Yashodhandesh/B6_Prototyping_2022/Prtotyping_1_tinkercad.jpg

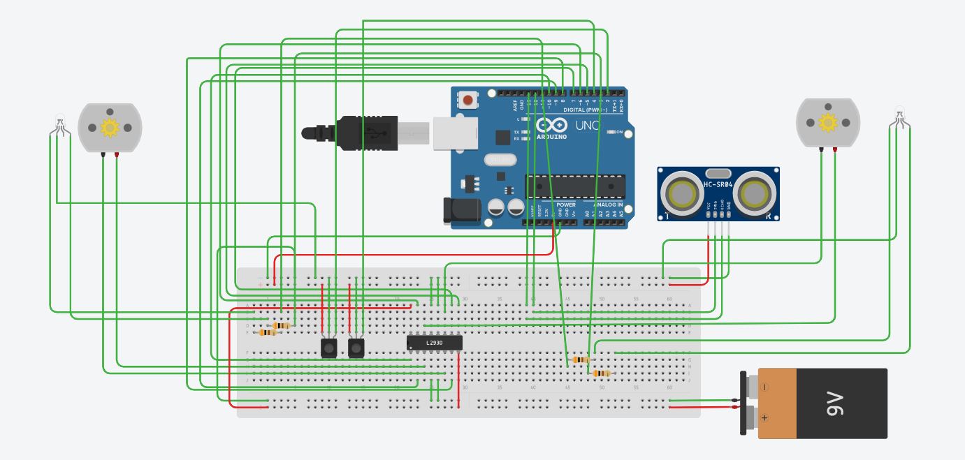
Prtotyping_1_tinkercad.jpg
