Yashodhandesh/B6_Prototyping_2022/design_style/DESIGN DISCUSSION(RETRO).pdf

DESIGN DISCUSSION(RETRO)

The aim is to recreate a vintage car design we know of but keep it simple.
The design had series of rounded edges as a normal vintage car look It also has the wheel bumper that was frequently used in old school cars. Our front part of the car consists of a well-designed classic bonnet with strips of line like was very prominent in classic cars.

We covered the battery part of the car to make the design more aesthetically pleasing.
We also added 4 wheels instead of 2 and a front wheel to give the car more movement capabilities and more balance.
The breadboard remained in the same position as it gives the car a classic Mercedes Benz look standing in as the flyer of the car. Our electronic components more or less remained a part of the design but their functional requirement was not met as we intended a more stylistic result.9
