Yashodhandesh/B6_Prototyping_2022/PROTOTYPING DOCUMENTATION/Affidavit/2022-06-19 10_19_44-affidevate.docx - yashodhan.pdf

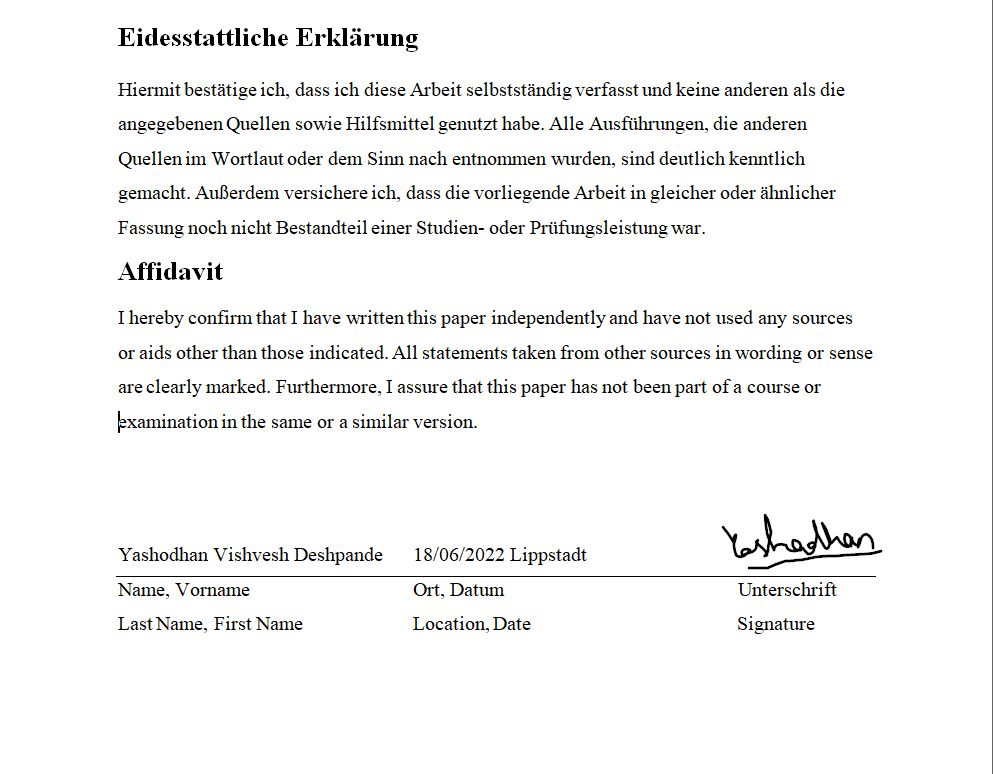
[picture p46: page 1]
