Yashodhandesh/B6_Prototyping_2022/final_system_engineering_model/Activity final.jpeg

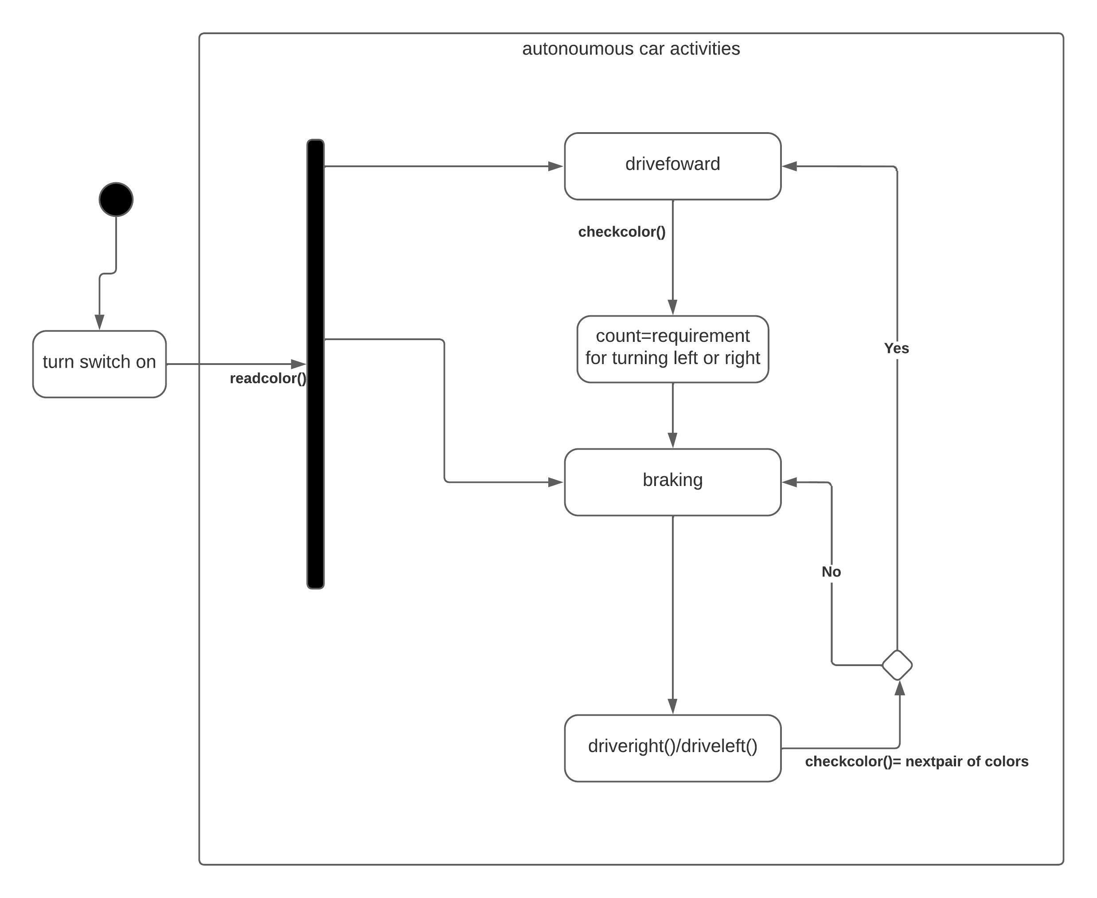
final_system_engineering_model/Activity final.jpeg
