Yashodhandesh/B6_Prototyping_2022/final_system_engineering_model/smart car bbd.jpg

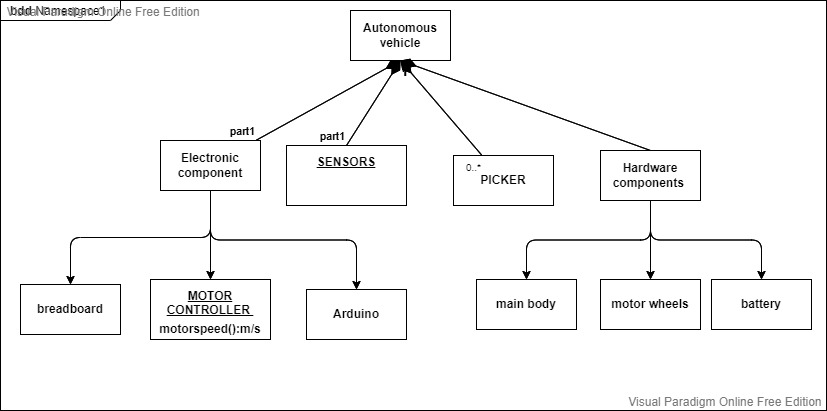
final_system_engineering_model/smart car bbd.jpg
