Yashodhandesh/B6_Prototyping_2022/final_system_engineering_model/software models/Differentiate color (task 2).jpeg

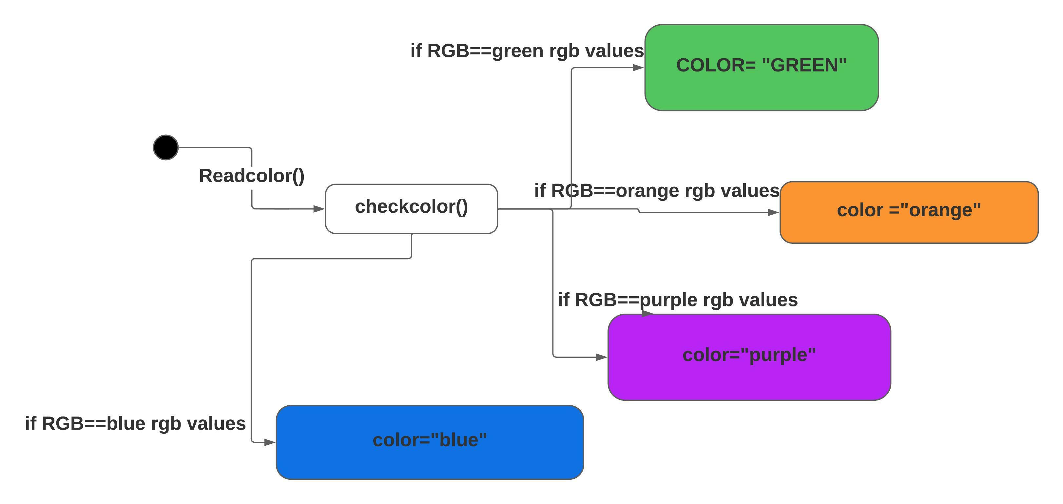
final_system_engineering_model/software models/Differentiate color (task 2).jpeg
