Yashodhandesh/B6_Prototyping_2022/final_system_engineering_model/software models/LINE FOLLOW STATE MACHINE (task 1).jpeg

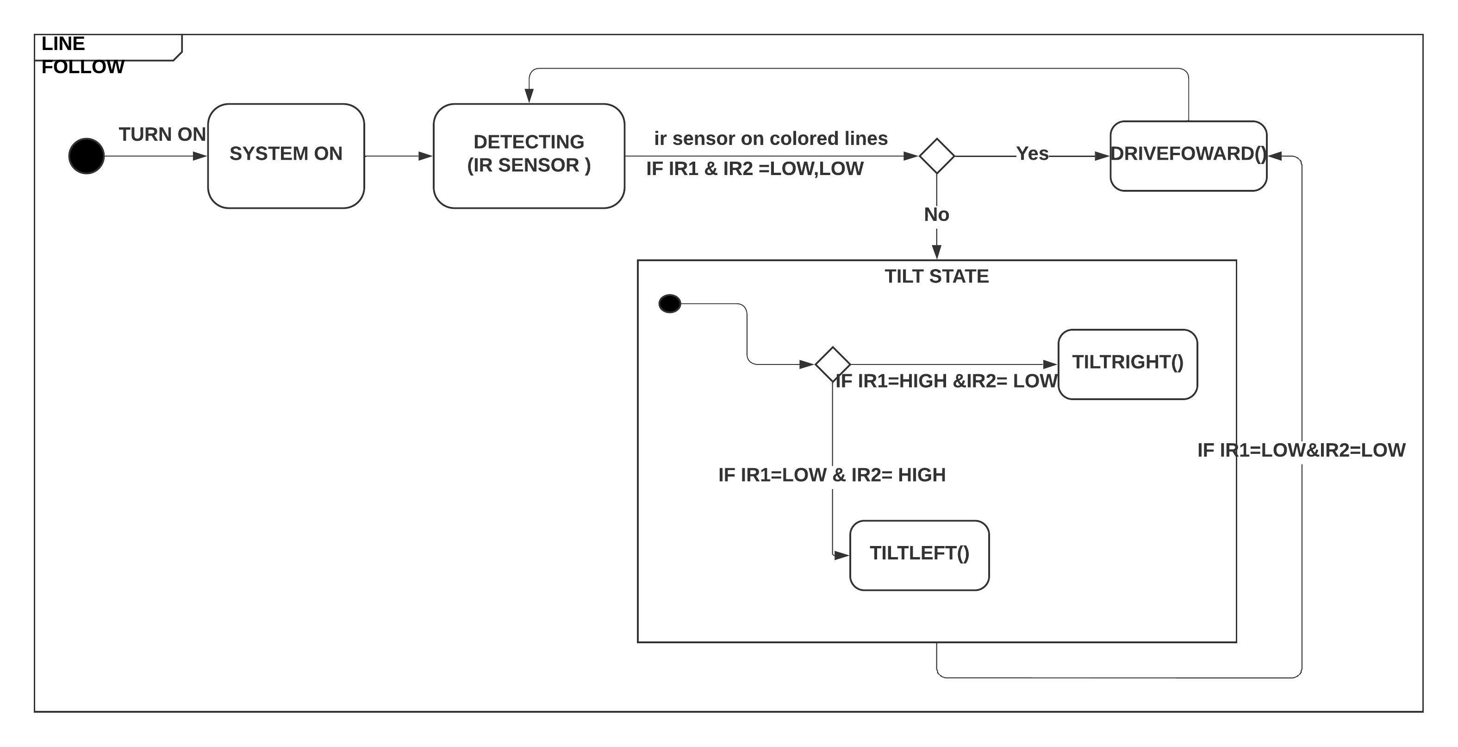
final_system_engineering_model/software models/LINE FOLLOW STATE MACHINE (task 1).jpeg
