Yashodhandesh/B6_Prototyping_2022/final_system_engineering_model/software models/Task 3.jpeg

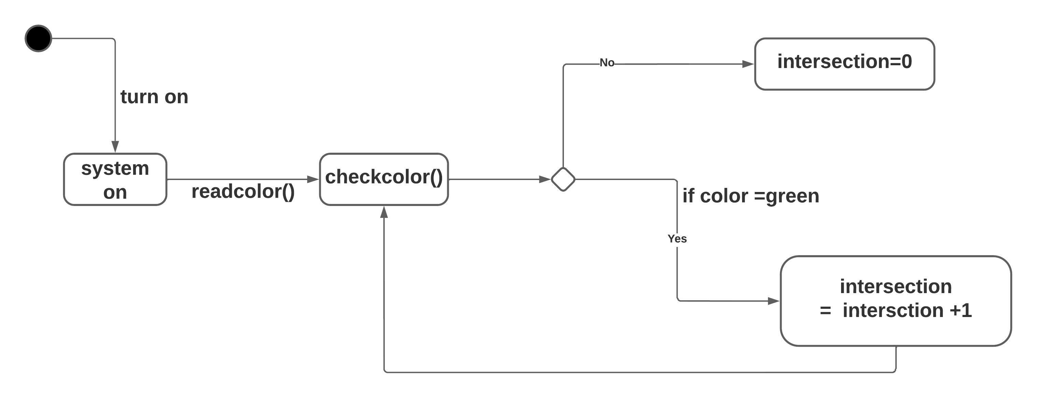
final_system_engineering_model/software models/Task 3.jpeg
