Yashodhandesh/B6_Prototyping_2022/requirement diagram.jpg

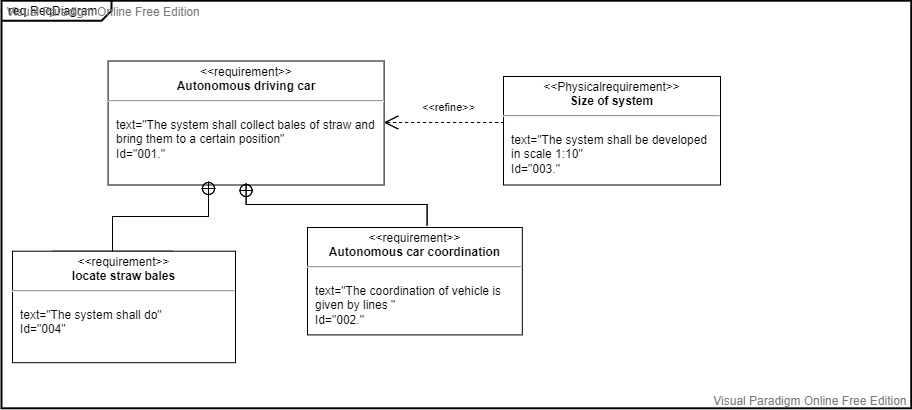
requirement diagram.jpg
