Yashodhandesh/B6_Prototyping_2022/stm (1).jpg

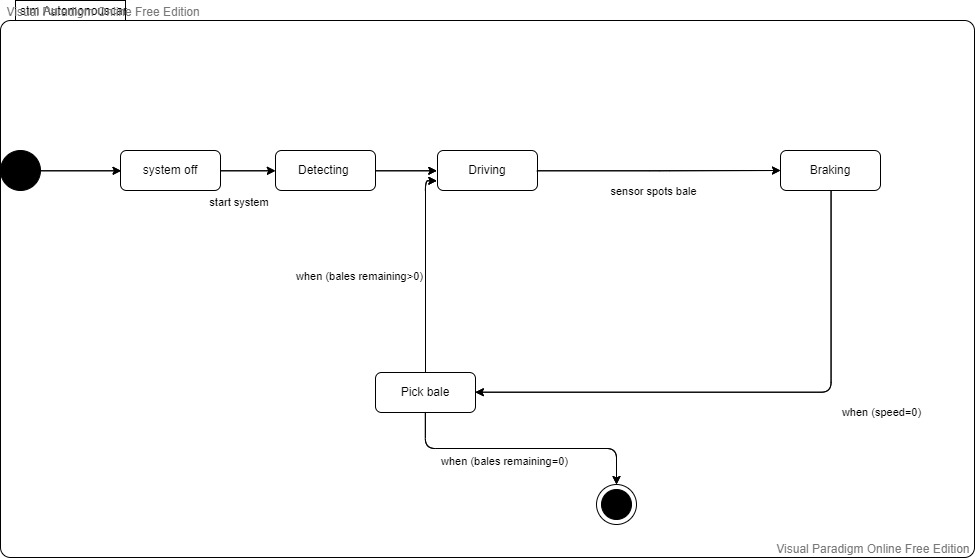
stm (1).jpg
