Yashodhandesh/B6_Prototyping_2022/stm.jpg

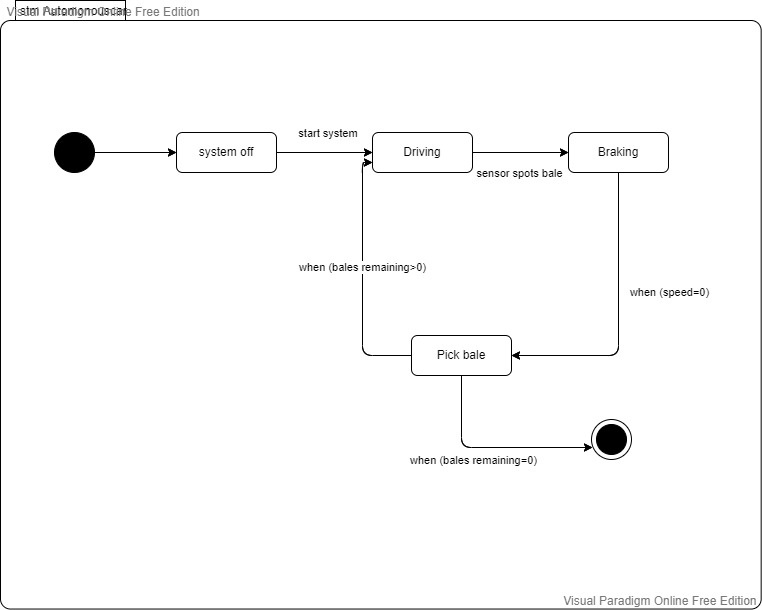
stm.jpg
