Yashodhandesh/B6_Prototyping_2022/updated system models/FIRST SCENARIO TASK 1.jpeg

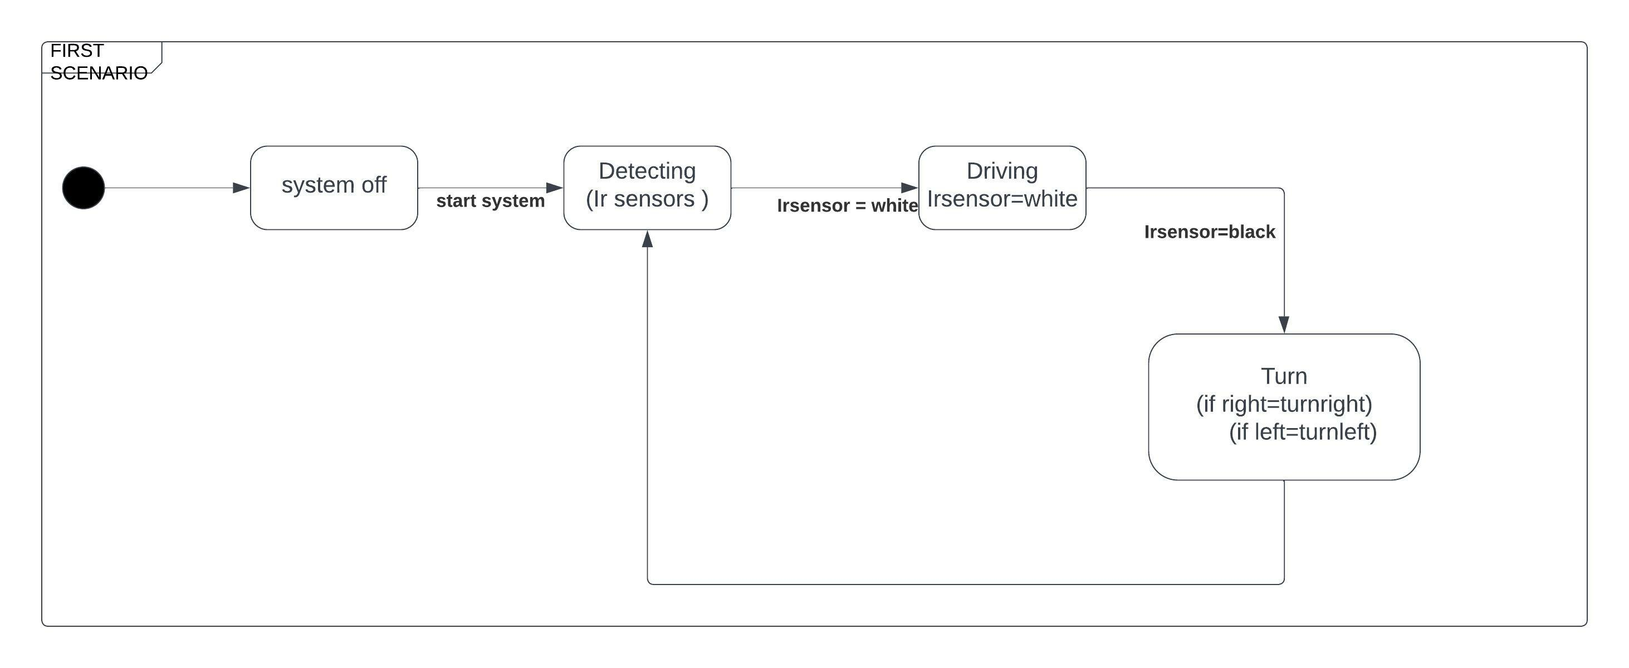
updated system models/FIRST SCENARIO TASK 1.jpeg
