Yashodhandesh/B6_Prototyping_2022/updated system models/OBSTACLE DETECTION.jpeg

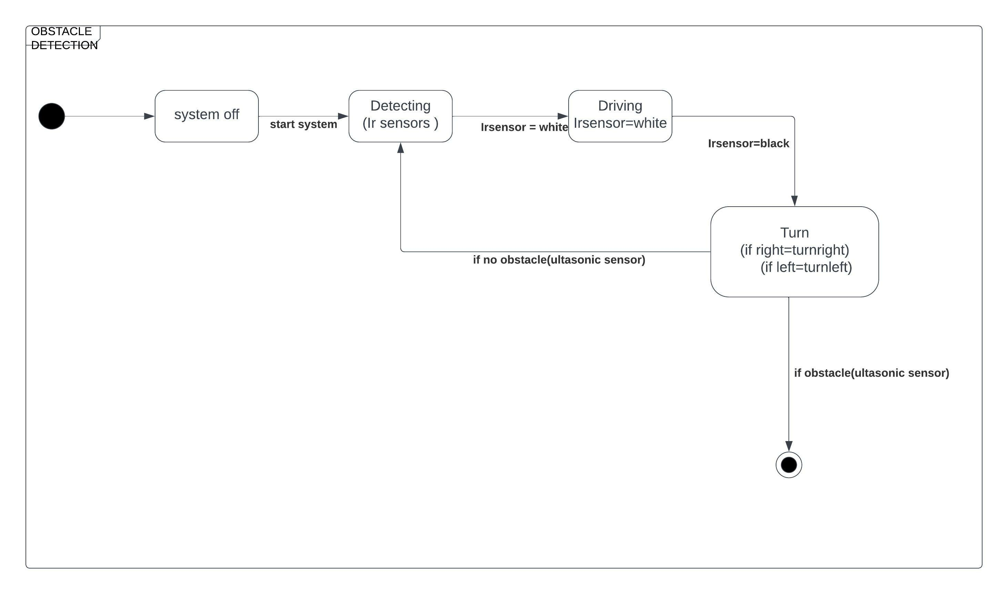
updated system models/OBSTACLE DETECTION.jpeg
