Yashodhandesh/B6_Prototyping_2022/updated system models/updated requirement diagram.jpg

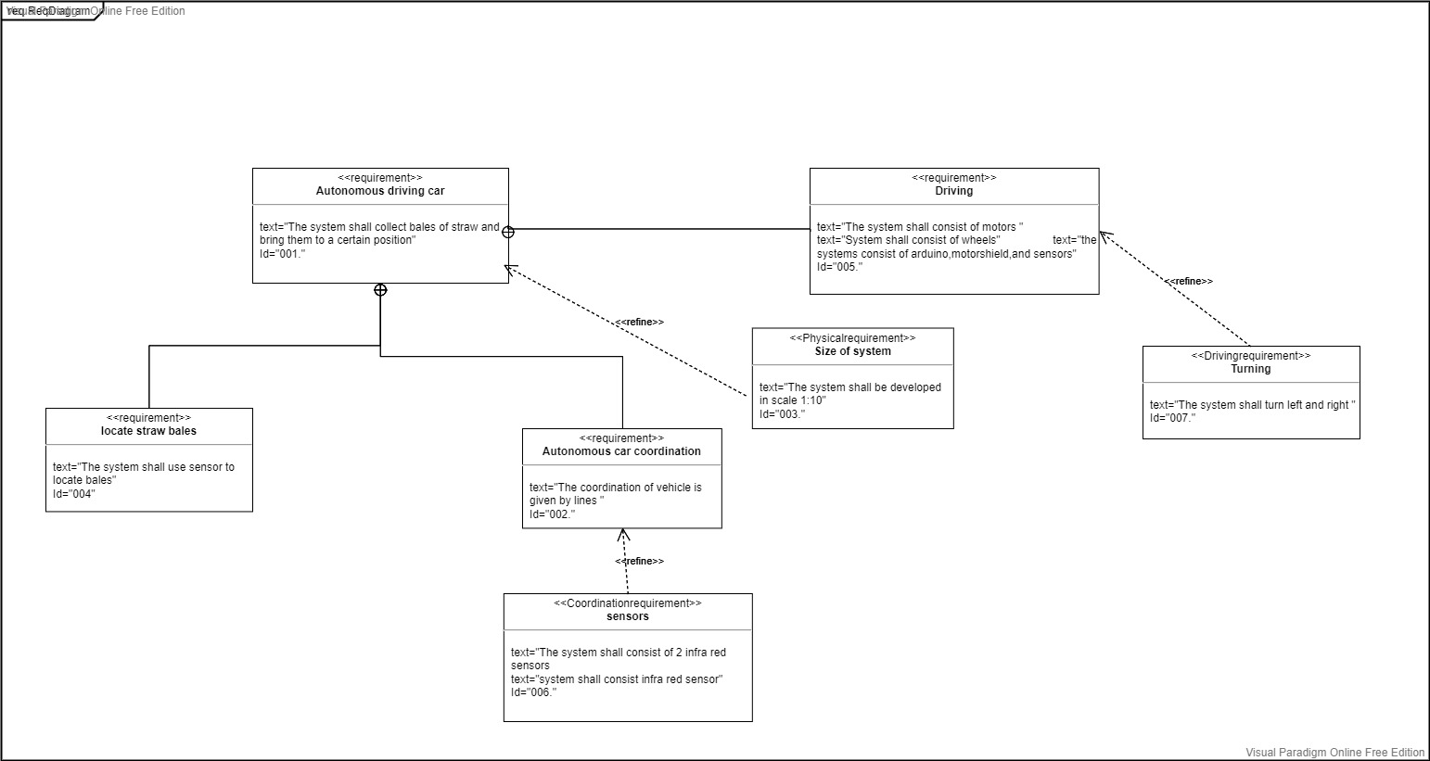
updated system models/updated requirement diagram.jpg
