Yashodhandesh/B6_Prototyping_2022/design_functional/Smart_Vehicle_assembly.stp

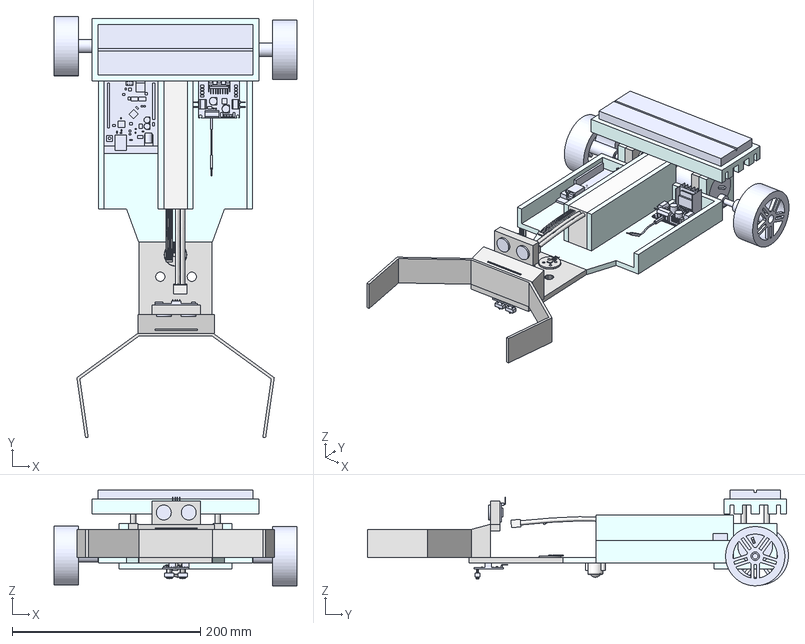
[picture p58: CAD file, 2022-06-08]
design_functional/Smart_Vehicle_assembly.stp
257.8 x 447.4 x 101.7 mm
robotplatform
robotC1 x 2
robotC2 x 2
color
plat1
picker
robotC3
ultrasonic_bracket
robotB2
robotB1_MIR x 2
robotA1
robotDocument
robotB3
robotDocument_1
