Yashodhandesh/B6_Prototyping_2022/neewrobotrobot_assembly-step.stp

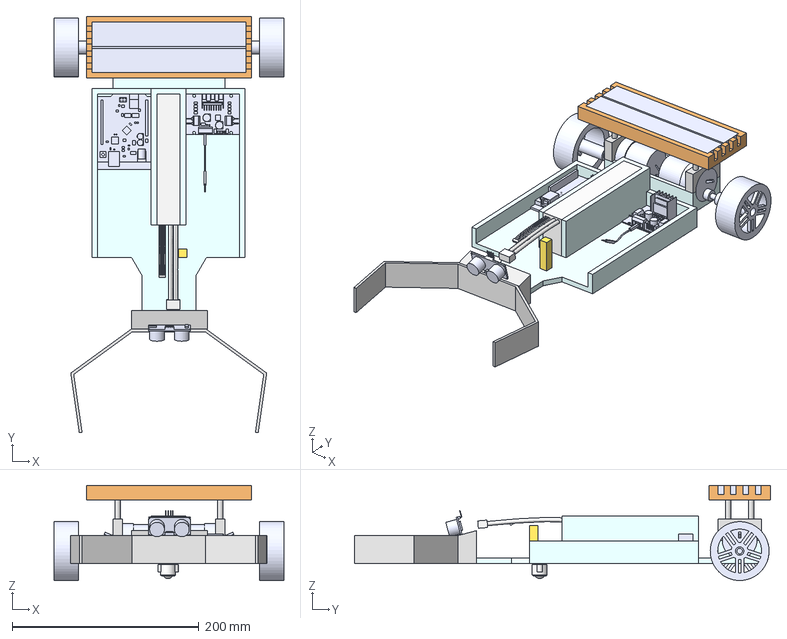
[picture p59: CAD file, 2022-05-01]
neewrobotrobot_assembly-step.stp
245.8 x 445.2 x 101.7 mm
robotplatform
robotC1 x 2
robotC2 x 2
robotB2
robotDocument_1
robotBody
robotA1
motorshield
robotDocument
robotC3
picker
