Yashodhandesh/B6_Prototyping_2022/smartfarming vehicle/mainbody.stl

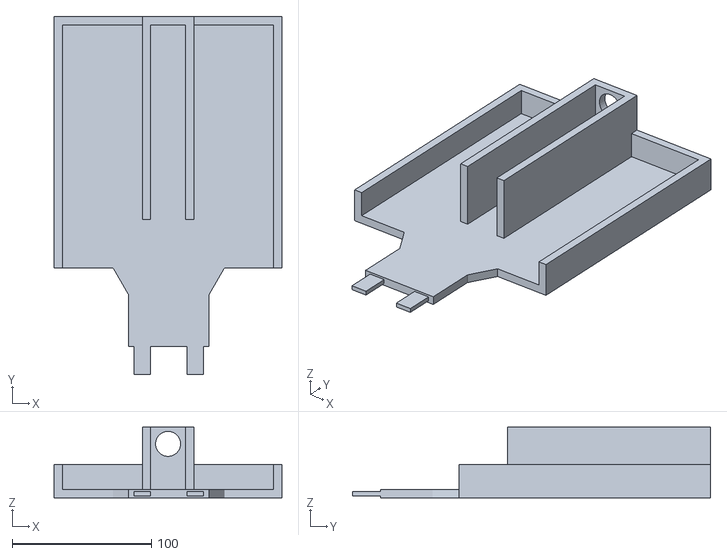
[picture p60: CAD file, 2022-05-04]
smartfarming vehicle/mainbody.stl
163.9 x 257.5 x 51.0
