Yashodhandesh/B6_Prototyping_2022/design_style/RETRO DESIGN.stp

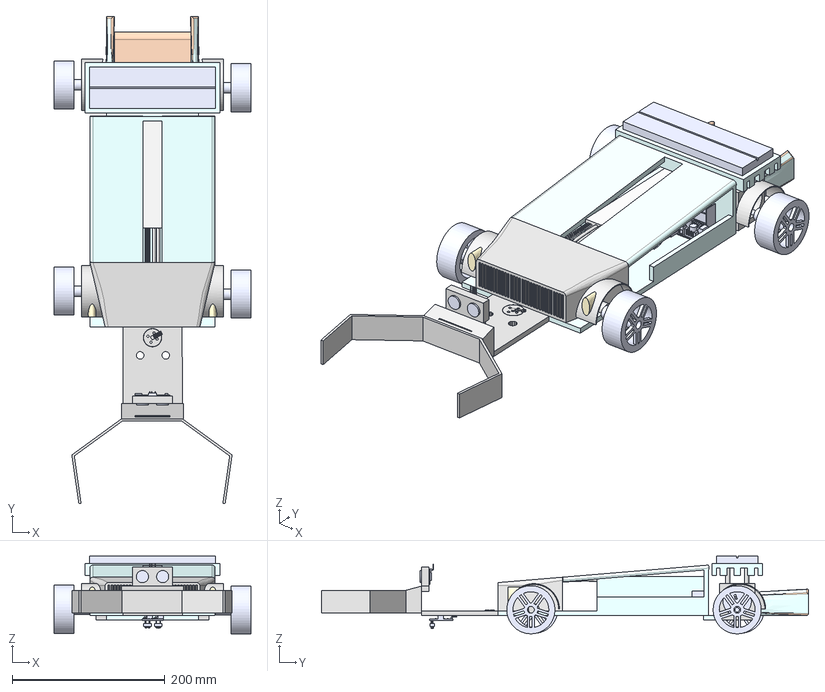
[picture p61: CAD file, 2022-06-19]
design_style/RETRO DESIGN.stp
257.8 x 637.3 x 101.7 mm
robotplatform
robotC1 x 2
color
robotC3
robotB1_MIR x 2
robotA1
robotDocument
robotB3
robotC2 x 4
plat1
picker
ultrasonic_bracket
robotB2
