Yashodhandesh/B6_Prototyping_2022/Assem1.STEP

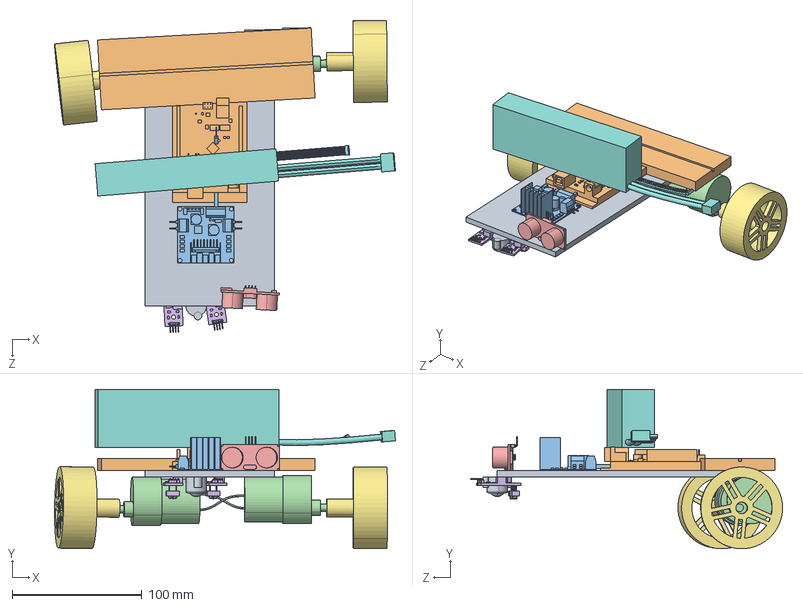
[picture p62: CAD file, 2022-04-27]
Assem1.STEP
262.9 x 122.9 x 240.7 mm
plywood
arduino-UNO
motorcontroler
motor x 2
ultrasonic-sensor
infrared-sensor x 2
wheel-basic x 2
lipo-battery
front-wheel
breadboard
