Yashodhandesh/B6_Prototyping_2022/smartfarming vehicle/breadboardstand v2 v0.stl

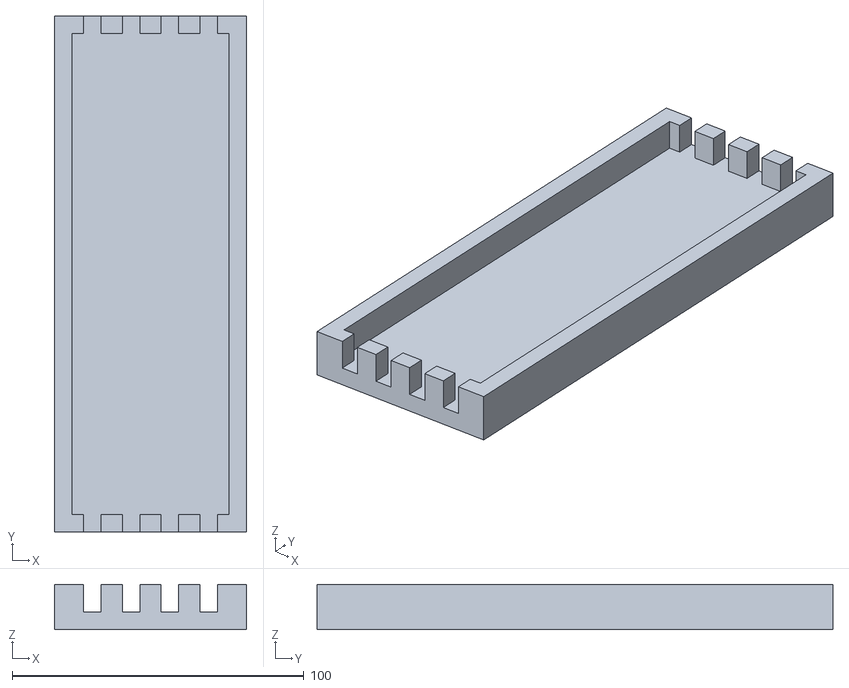
[picture p63: CAD file, 2022-05-04]
smartfarming vehicle/breadboardstand v2 v0.stl
66.0 x 177.0 x 15.6
