Yashodhandesh/B6_Prototyping_2022/smartfarming vehicle/motorcompartment.stl

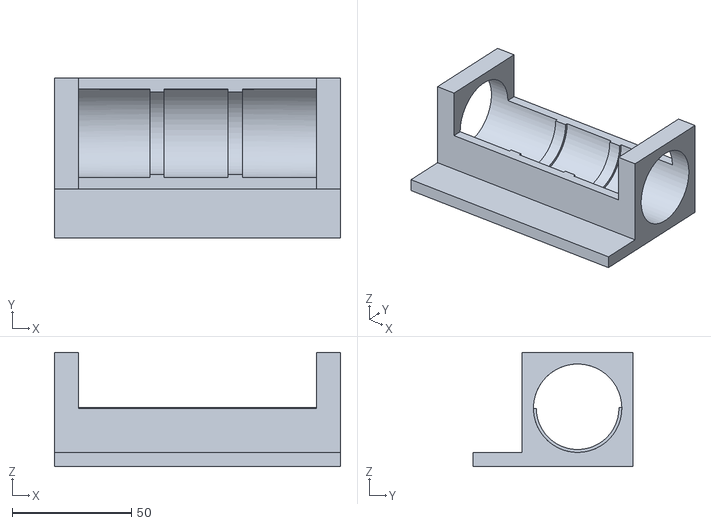
[picture p64: CAD file, 2022-05-04]
smartfarming vehicle/motorcompartment.stl
120.0 x 67.3 x 48.0
