Yashodhandesh/B6_Prototyping_2022/smartfarming vehicle/updated vehcile body v1.stl

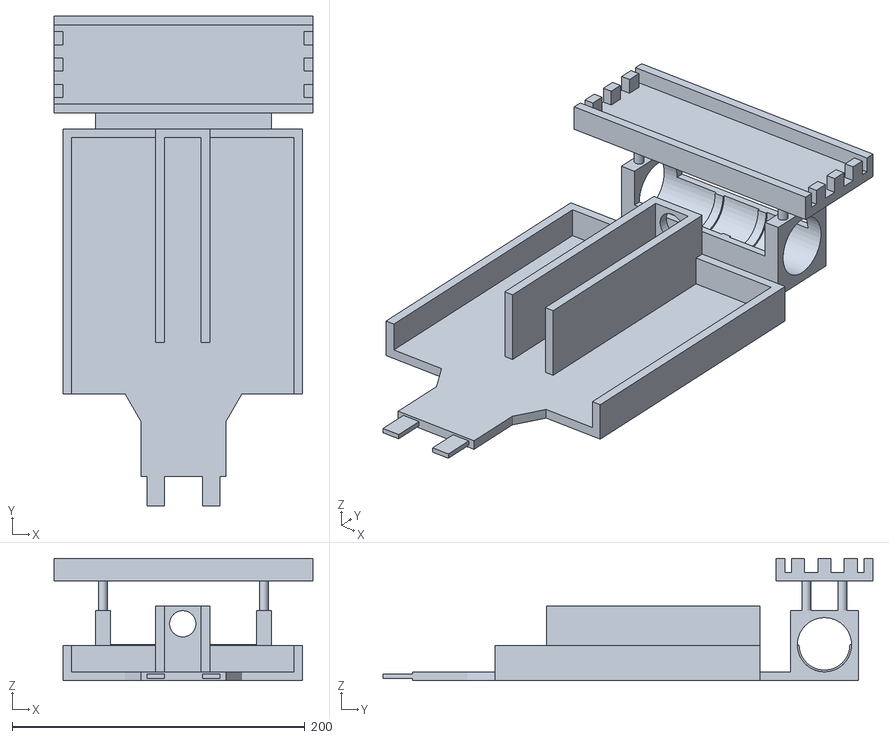
[picture p65: CAD file, 2022-05-03]
smartfarming vehicle/updated vehcile body v1.stl
177.0 x 334.5 x 83.6
