Yashodhandesh/B6_Prototyping_2022/smartfarming vehicle/picker final version.stl

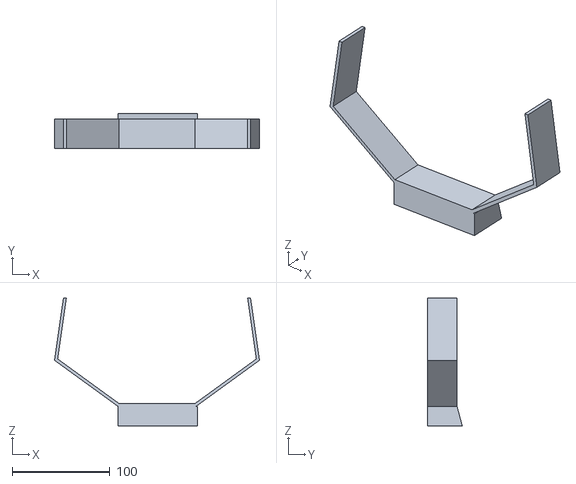
[picture p66: CAD file, 2022-05-01]
smartfarming vehicle/picker final version.stl
209.8 x 35.4 x 130.7
