Yashodhandesh/B6_Prototyping_2022/smartfarming vehicle/motor clamp x2 v1.stl

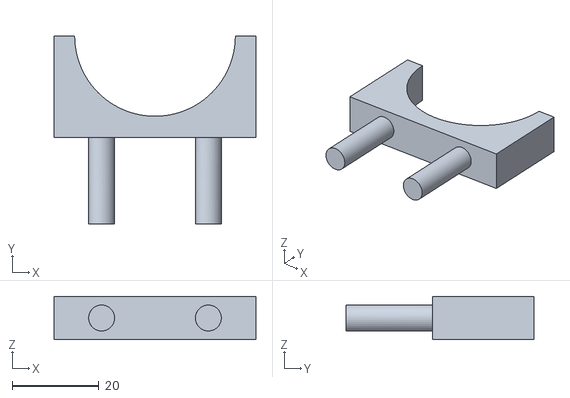
[picture p67: CAD file, 2022-05-01]
smartfarming vehicle/motor clamp x2 v1.stl
46.6 x 43.5 x 10.0
