Yashodhandesh/B6_Prototyping_2022/(list of files, cad)

Other CAD files:
smartfarming vehicle/updatedsmartfarmingvehicle_assembly-step v1.step
smartfarming vehicle/smartfarmin_vehicle _assembly-step.step
smartfarming vehicle/breadboardhold v1.dxf
