Yashodhandesh/B6_Prototyping_2022/(commit log)

2022-05-01 Create prototype
2022-06-08 Create smarfarming models for prototyped model
